shubham6531/ACC_-_Lane_Keep_Assist/Report_ACC_with_Lane_Keep.pdf

## AuE 8350

## Automotive Electronics Integration

## Project 2 Report

## Fall 2021

## Submitted By:

### Shubham Gupta

C38771108

### gupta9@clemson.edu

## Project 2: Adaptive Cruise Control and Autonomous Lane Keeping

### Task 1: Adaptive Cruise Control

### 1.1 Problem Statement

The vehicle shall be able to exhibit Adaptive Cruise Control capabilities, i.e, it should be able to autonomously change its speed such that it stays 30 cm away from the obstacles ahead. Furthermore, if the obstacle ahead is stationary, then the vehicle should stop 30 cm away from the obstacle.

### 1.2 Technical Approach

The vehicle was controlled using a Proportional-Integral-Derivative (PID) controller. The PID controller provided us with an easy yet robust method of implementing adaptive cruise control, and we did not need to model the system.

The PID controller can be represented using the following equation:

where:

- u(t): PID control variable
- e(t): Error signal
- Kp: Proportional Gain
- Ki: Integral Gain
- Kd: Derivative Gain

However, since Arduino can only handle discrete data, we implement the PID controller on an Arduino as follows:

u(k) = u(k-1) + k1*e(k) + k2*e(k-1) + k3*e(k-2);

where:
- k1 = kp + ki + kd
- k2 = ‐kp ‐2*kd
- k3 = kd

### 1.3 Hardware and Software Implementation:

The following pictures demonstrate our setup for the project:

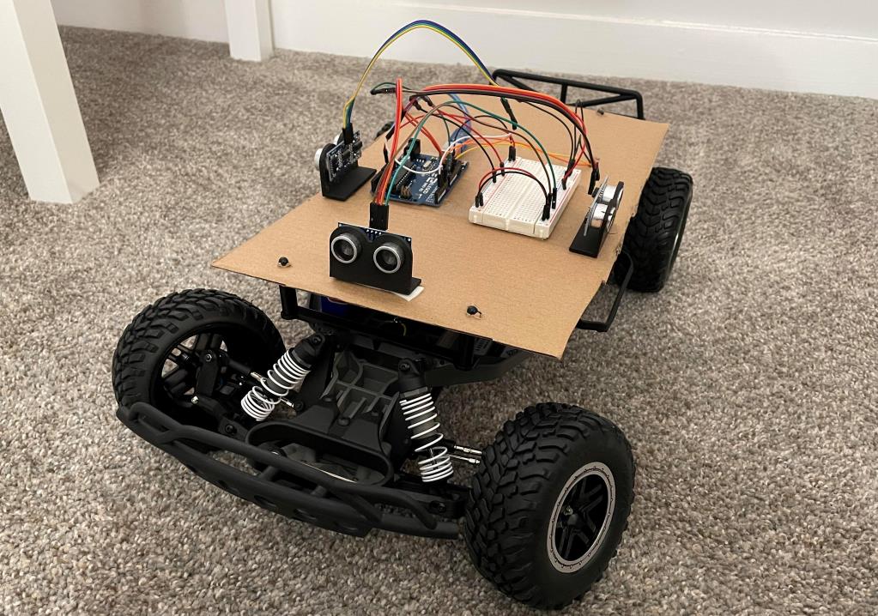
[picture p1: figure]

Our setup consisted of the following components
- RC Car
- Arduino Uno
- Front: One HC-SR04 sensor
- Sides: One HC-SR04 sensor each on left and right sides of the vehicle
- Breadboard
- Cardboard base to place the components
- Connecting wires

Additional Components (optional):

- 3D Printed Sensor Mounts

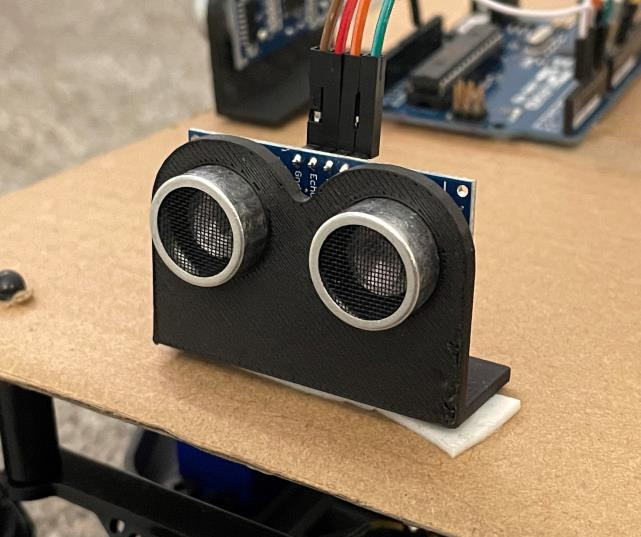
[picture p2: figure]

- Power Bank (to power Arduino)

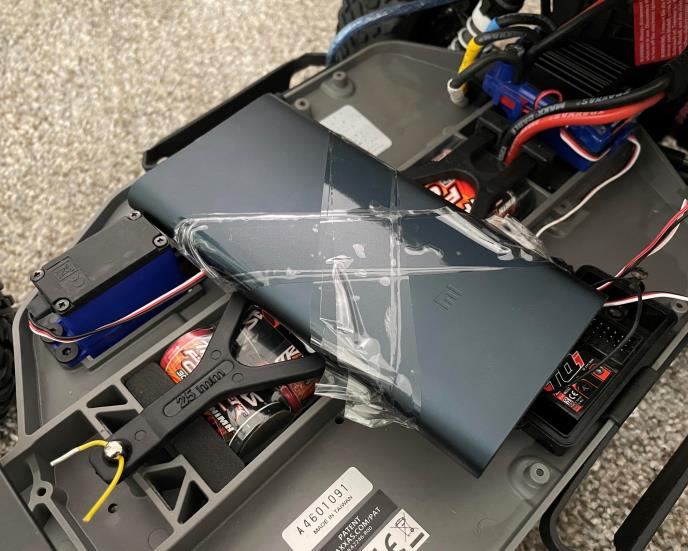
[picture p3: figure]

PID Controller Implementation
The PID Controller is a non-model based controller and is implemented using the discrete data version on an Arduino. For Adaptive Cruise Control, the PID uses data from the ultrasonic sensor in the front to calculate error signal, and provide the required throttle response.
- Throttle = 90 for zero throttle
- Throttle > 90 for forward acceleration
- Throttle < 90 for backward acceleration

The PID controller parameters are as follows:

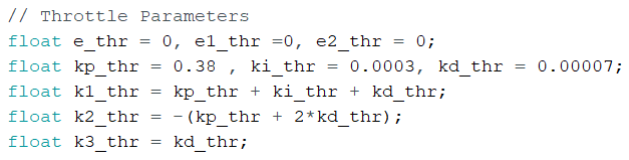
[picture p4: figure]

Handling the Dead Zone
The RC car motor has a noticeable dead zone (between throttle = 86 and throttle = 94). Therefore, we need to handle this by starting the forward throttle values at 94 and backward throttle values at
86. Therefore, the PID controller is implemented as follows on the Arduino:

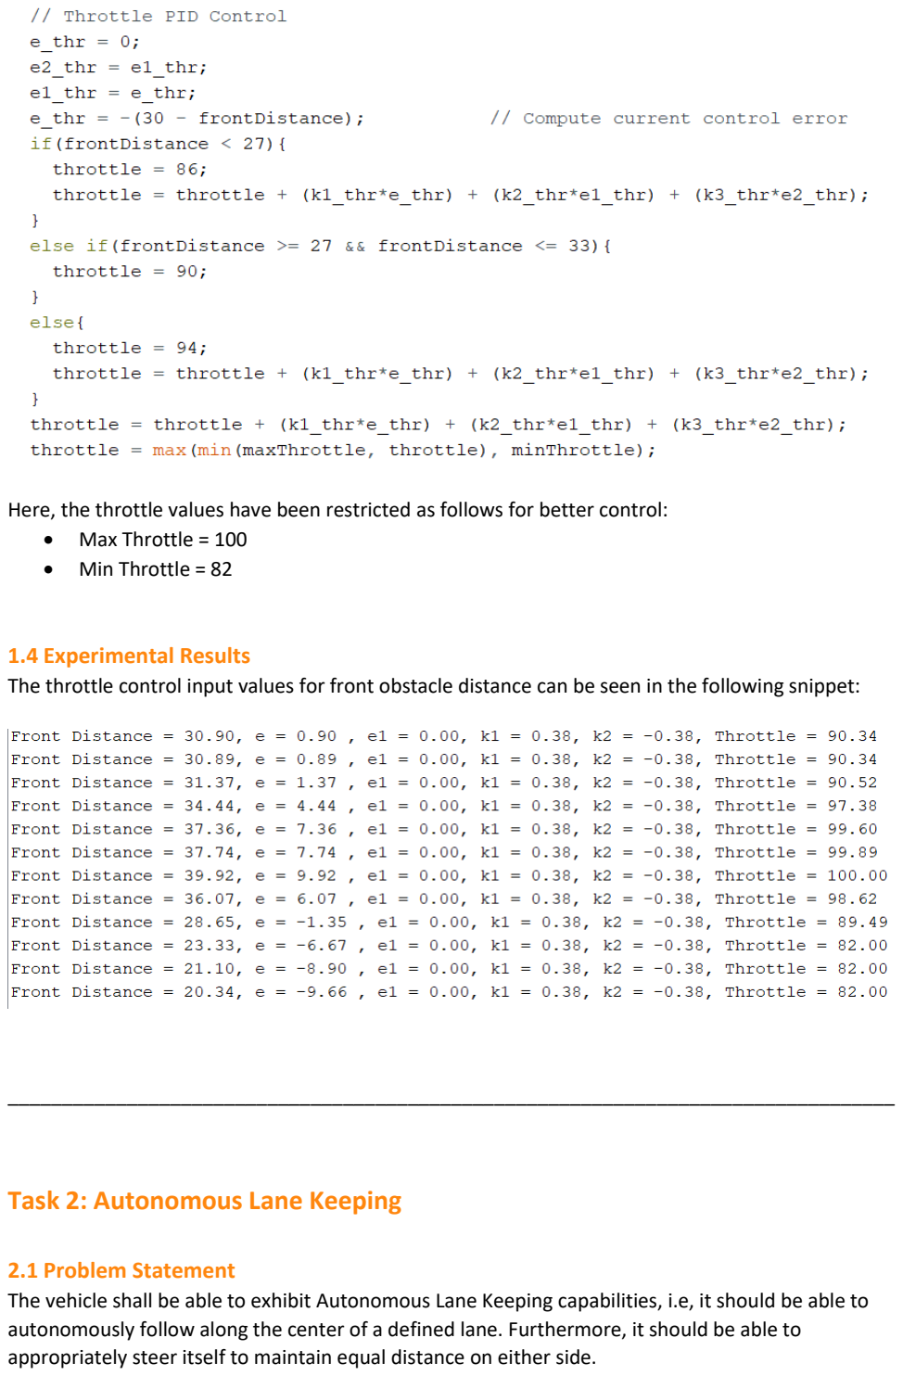
[picture p5: page 5]

Here, the throttle values have been restricted as follows for better control:
- Max Throttle = 100
- Min Throttle = 82

### 1.4 Experimental Results

The throttle control input values for front obstacle distance can be seen in the following snippet:

__________________________________________________________________________________

### Task 2: Autonomous Lane Keeping

### 2.1 Problem Statement

The vehicle shall be able to exhibit Autonomous Lane Keeping capabilities, i.e, it should be able to autonomously follow along the center of a defined lane. Furthermore, it should be able to appropriately steer itself to maintain equal distance on either side.

### 2.2 Technical Approach

The Autonomous Lane Keeping assist was controlled using a Proportional-Integral-Derivative (PID) controller. The PID controller provided us with an easy yet robust method and we did not need to model the system.

The PID controller can be represented using the following equation:

where:

- u(t): PID control variable
- e(t): Error signal
- Kp: Proportional Gain
- Ki: Integral Gain
- Kd: Derivative Gain

However, since Arduino can only handle discrete data, we implement the PID controller on an Arduino as follows:

u(k) = u(k-1) + k1*e(k) + k2*e(k-1) + k3*e(k-2);

where:
- k1 = kp + ki + kd
- k2 = ‐kp ‐2*kd
- k3 = kd

### 2.3 Hardware and Software Implementation:

The hardware implementation is the same as that in Task 1 (Adaptive Cruise Control). The following pictures demonstrate our setup for the project:

Our setup consisted of the following components
- RC Car
- Arduino Uno
- Front: One HC-SR04 sensor
- Sides: One HC-SR04 sensor each on left and right sides of the vehicle
- Breadboard
- Cardboard base to place the components
- Connecting wires
- 3D Printed Sensor Mounts
- Power Bank (to power Arduino)

PID Controller Implementation

The PID Controller is a non-model based controller and is implemented using the discrete data version on an Arduino. For Autonomous Lane Keeping, the PID uses data from the ultrasonic sensors on the left and right to calculate error signal, and provide the required steering response.
- Throttle = 90 for neutral steering i.e no turning
- Throttle > 90 for turning right
- Throttle < 90 for turning left

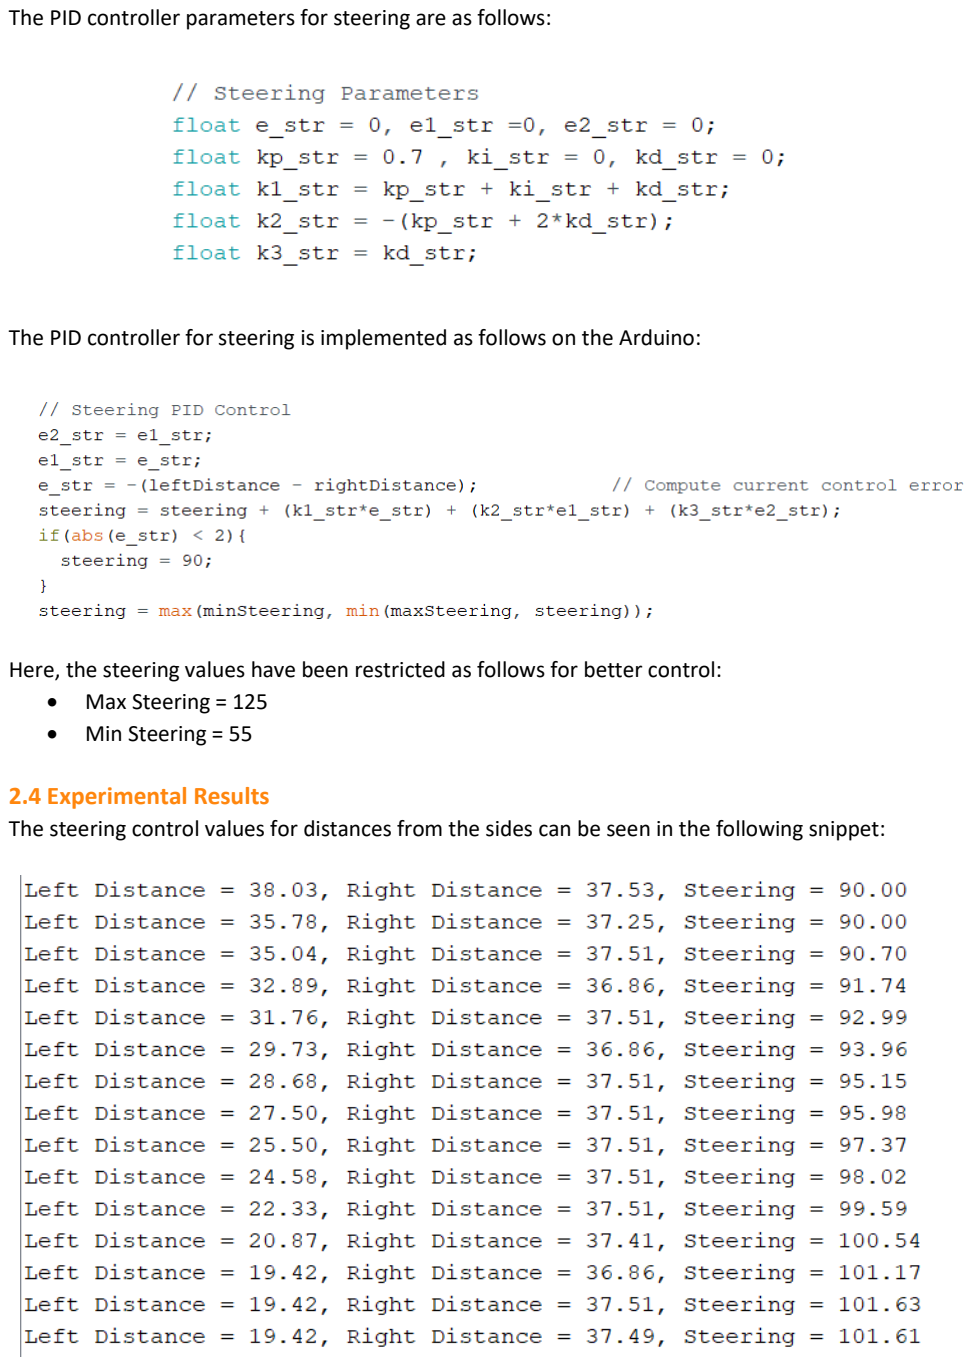
[picture p6: page 8]

The PID controller parameters for steering are as follows:

The PID controller for steering is implemented as follows on the Arduino:

Here, the steering values have been restricted as follows for better control:
- Max Steering = 125
- Min Steering = 55

### 2.4 Experimental Results

The steering control values for distances from the sides can be seen in the following snippet:

### Conclusions and Discussion

### 1.1 Conclusions

- Impact of Battery SOC:
- The state of charge of the RC vehicle battery impacted the throttle response of the vehicle. At a higher state of charge, the acceleration experienced for the same throttle input was higher.
- As a result, the response of the PID controller for the given Kp, Ki and Kd parameters changed significantly.
- Throttle Dead Zone:
- As discussed, the throttle input experiences a dead zone. Therefore, it is essential to identify the range of the dead zone and incorporate that information into the controller.
- Data Type for Variables:
- An interesting find was that the chosen data type for a variable can significantly impact results. For example, if the variable corresponding to throttle input is taken as an integer, the throttle values keep decreasing for a constant obstacle distance. Whereas, using a float variable avoids this issue.
- Sensor Noise:
- The ultrasonic sensors are prone to noise and can adversely impact throttle response if measured distance has very high inaccuracy.
- Power Source for Steering Servo
- Power the steering servo motor using the Arduino introduces noise in the ultrasonic sensor readings whenever the servo draws current from the Arduino. Therefore, it is recommended that the servo is powered from the ESC.

### 1.2 Discussion

Even though the PID controller has proved to be a good implementation technique, we can obtain more robust control using model-based controllers. Controllers such as Model Predictive Control (MPC) can provide better results.

Apart from the model-based controllers, other non-model-based controllers such as Reinforcement learning and Supervised learning techniques can also provide robust control. The only challenge with these approaches is that they require significant amount of training data to perform well.
