shubham6531/ACC_-_Lane_Keep_Assist/Report_Kalman_Filtering.pdf

## AuE 8350

## Automotive Electronics Integration

## Project 1 Report

## Fall 2021

## Submitted By:

### Shubham Gupta

C38771108

### gupta9@clemson.edu

## Project 1: Sensing Signal Processing

### Task 1: Signal Processing for One Ultrasonic Sensor

### 1.1 Problem Statement

The Task 1 aims to implement a Kalman filter using an Arduino microcontroller to filter the noise from an ultrasonic sensor reading. In general, an ultrasonic sensor is used to measure distance of an object in front of it. While the ultrasonic sensor can be used without a filter, the obtained measurements are noisy, and we obtain fluctuations in measurements for the same distance. Therefore, a simple yet powerful filter like the Kalman filter is implemented in this project.

To achieve the above goal, the following steps need to be fulfilled:
- Sampling: Sample the time data of an ultrasonic sensor as quickly as possible
- Filtering: Implement a Kalman filter to filter out the noise from the readings
- Calibration: Identify an appropriate function to map the measured time values to the corresponding distance values

Furthermore, the following performance metrics need to be met for the Kalman filter:
- Converge the Kalman filter as quickly as possible (less than 10 seconds)
- Accuracy of calculated distance must be within +/-3 mm

### 1.2 Technical Approach

The task at hand was fulfilled by completing the steps highlighted in the problem statement as follows:

### 1. Sampling

Time readings were sampled from the ultrasonic sensor as fast as possible.
- For our project, chosen sampling time = 10 milliseconds
- Note that these measured time values are noisy and need to be filtered to obtain a reliable time value. The following snippet shows time values for the same distance:

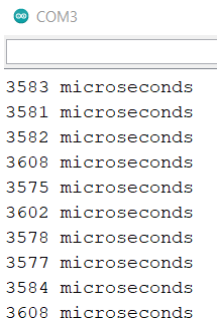
[picture p7: figure]

### 2. Kalman Filter

To implement a Kalman filter for one ultrasonic sensor, the following Prediction and Correction equations were used:

Process Model:
yk = 1*yk‐1
zk = 1*yk + vk

where:
- y: system state (time values)
- k: discrete time value
- z: measured data (time measurement from sensor)
- v: measurement noise
Prediction | Correction
‐ ŷ k = yk‐1 ‐ P k = Pk‐1 where: • ŷ ‐ k : Predicted value based on previous measurement • P ‐ k : Predicted error covariance | K = P‐ k (P‐ k + R)‐1 ŷk = ŷ‐ k + K(zk ‐ ŷ‐ k) Pk = (I ‐K) P ‐ k where: • K: Kalman Gain • ŷk : Estimated State • Pk : Estimated error covariance
i) Error Covariance R
To implement Kalman filter using above equations, we first need to determine the error covariance R. This was determined by taking 100 samples each at different distances from the sensor within the CU-ICAR auditorium and calculating the covariance within those measurements. The calculated error covariances were then included in our codes for Kalman filter.

The code for calculating R is as follows:

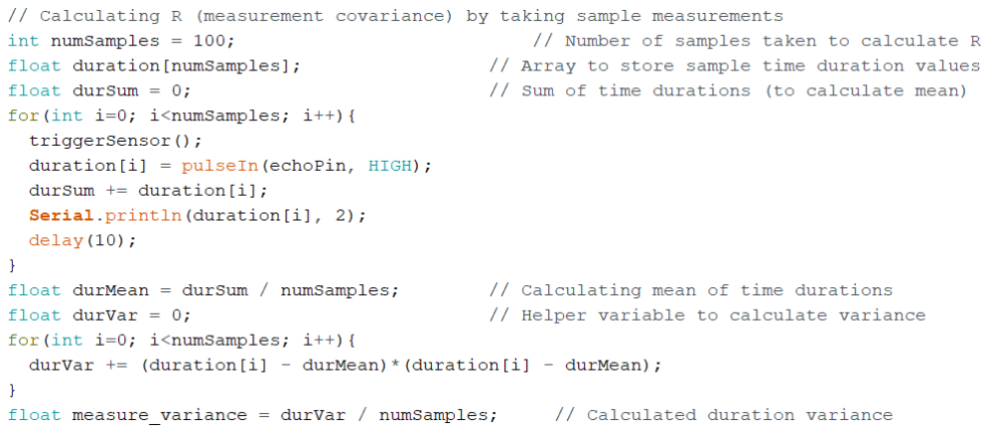
[picture p8: figure]
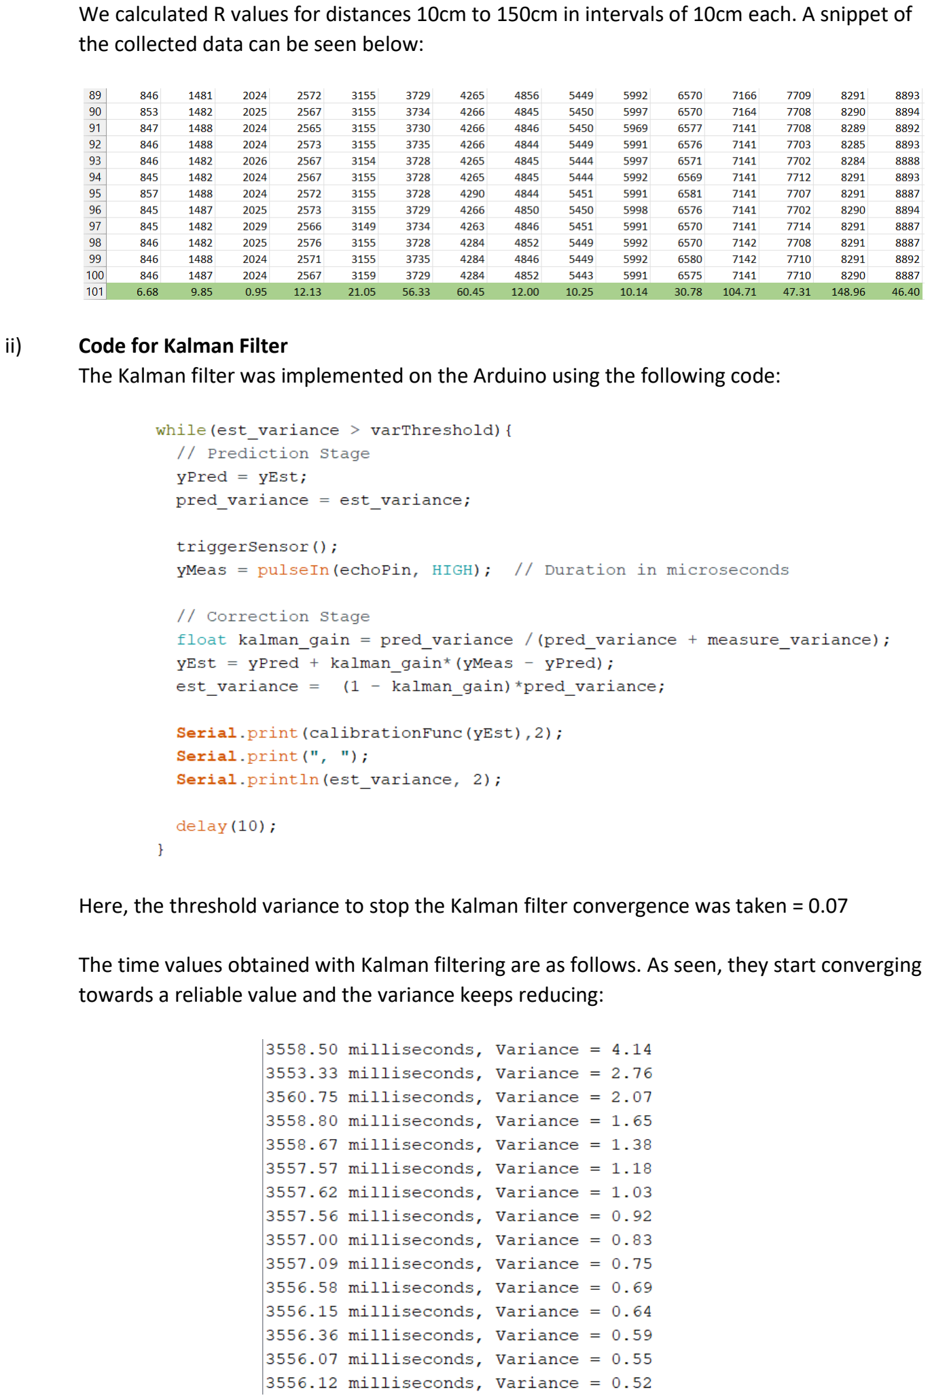
[picture p9: page 4]

We calculated R values for distances 10cm to 150cm in intervals of 10cm each. A snippet of the collected data can be seen below:

ii) Code for Kalman Filter The Kalman filter was implemented on the Arduino using the following code:

Here, the threshold variance to stop the Kalman filter convergence was taken = 0.07

The time values obtained with Kalman filtering are as follows. As seen, they start converging towards a reliable value and the variance keeps reducing:

### 3. Calibration:

The obtained filtered time values after Kalman filter need to be mapped to a physical distance value. To achieve this, we need to obtain a calibration function for the sensor being used. This function can be obtained as follows:

i) Obtain filtered time values for various distances:
The sensor was placed at various distances from an obstacle in front at the CU-ICAR auditorium to obtain the closest environment to the testing area. The corresponding filtered time values were noted. Similarly, the actual physical distance was measured using a measuring tape. These data were noted down as follows:

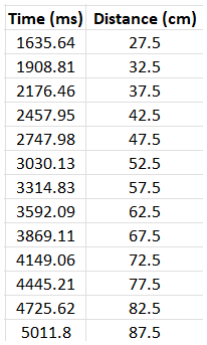
[picture p10: figure]

ii) Plot obtained data and Polyfit The obtained data was plotted in Matlab and polyfit function. Furthermore, since the graph appeared to have regions, we used a piece-wise function for calibration, which was obtained by using Polyfit function on the individual pieces of the graph:

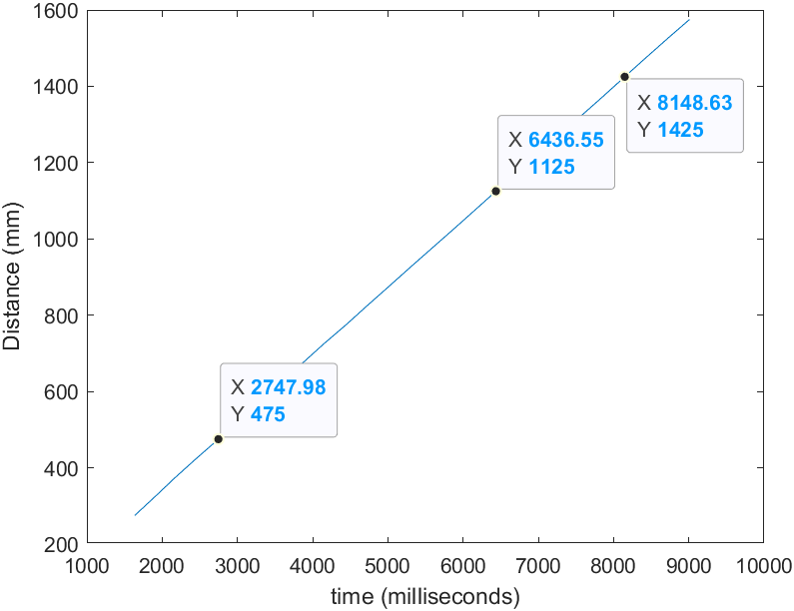
[picture p11: figure]

iii) Include Calibration Function in code The obtained piece-wise calibration function was added to the code to be able to obtain filtered distance values using the sensor.

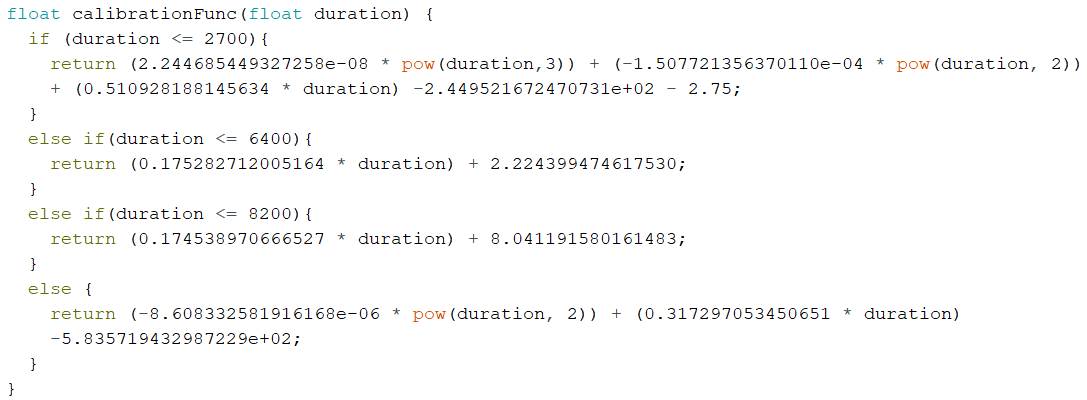
[picture p12: figure]

### 1.3 Hardware and Software Implementation:

The following circuit diagram demonstrates the setup used by our group for the project:

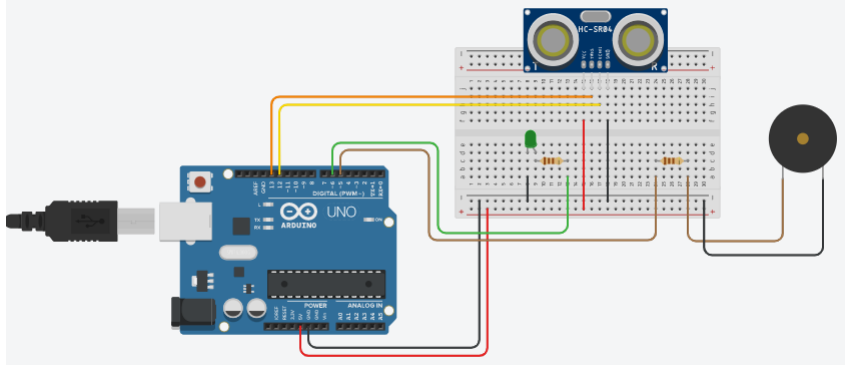
[picture p13: figure]

The components used are as follows:
- Arduino Uno R3
- One Ultrasonic Sensor (HC SR04)
- USB Cable
- 1 Breadboard
- 1 LED
- 1 Buzzer
- 2 Resistances (110 Ohms)
- Connecting wires

### 1.4 Experimental Results

The obtained distance values (in mm) and corresponding error covariance after the Kalman filter can be seen as follows:

Further Accomplishments:

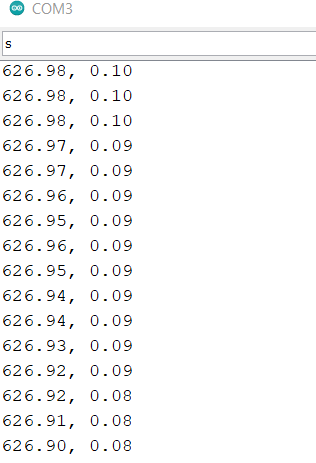
[picture p14: figure]

- The Kalman filter converges within 6 seconds for distance values from 20 cm to 150 cm
- The sensor setup is ideal for measuring distances within the above specified range at the CU-ICAR auditorium.
- Threshold variance for setup = 0.07

__________________________________________________________________________________

### Task 2: Sensor Fusion of Multiple Ultrasonic Sensors

### 2.1 Problem Statement

This task aims to fuse two ultrasonic sensors using the Kalman filter approach with the help of an Arduino microcontroller.

To achieve the above goal, the following steps need to be fulfilled:
- Sampling: Sample the time data of at least two ultrasonic sensors as quickly as possible
- Calibration: Identify appropriate calibration functions to map the measured time values to the corresponding distance values for each sensor
- Fusion: Implement a Kalman filter to fuse the readings from these multiple sensors and estimate the true distance.

Furthermore, the following performance metrics need to be met for the Kalman filter:
- Converge the Kalman filter as quickly as possible (less than 10 seconds)
- Accuracy of calculated distance must be within +/-3 mm

### 2.2 Technical Approach

The task at hand was fulfilled by completing the steps highlighted in the problem statement as follows:

### 1. Sampling

Time readings were sampled from the two ultrasonic sensors as fast as possible.
- For our project, a delay of 10 milliseconds was used between measurement readings from the two sensors. Furthermore, another delay of 10 milliseconds was used before taking the next set of measurements from the two sensors.

### 2. Calibration:

We derive the calibration function for the second sensor in this task (the sensor from Task 1 is being reused for sensor 1). The calibration function for sensor 2 is obtained using the same approach as in Task 1. The obtained piece-wise calibration function is as follows:

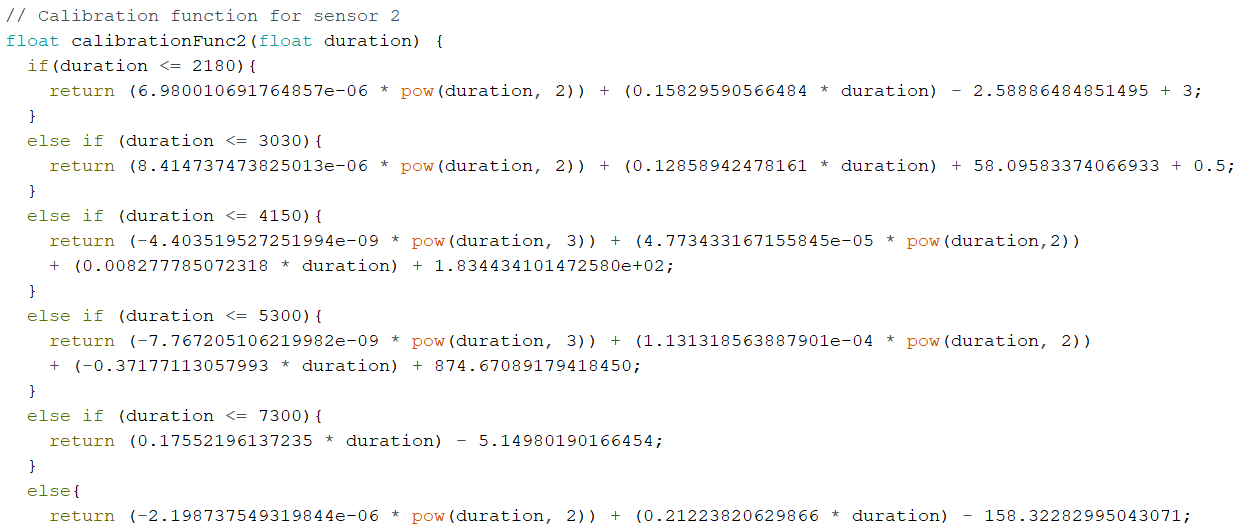
[picture p15: figure]

### 3. Kalman Filter

As opposed to Task 1, in Task 2 we implement the Kalman filter on distance values (obtained from raw time values). To implement a Kalman filter for two ultrasonic sensors, the following Prediction and Correction equations were used:

Process Model:
yk = 1*yk‐1
z1,k = 1*yk + v1,k
z2,k = 1*yk + v2,k

where:
- y: system state (time values)
- k: discrete time value
- z: measured data (time measurements from sensor 1 and 2)
- v: measurement noise

Prediction | Correction
ŷ ‐ k = yk‐1 ‐ P k = Pk‐1 where: • ŷ ‐ k : Predicted value based on previous measurement ‐ • P k : Predicted error covariance | Correction 1: K = P‐ k (P‐ ‐1 k + R1) ŷ1,k = ŷ‐ k + K(z1,k ‐ ŷ‐ k) P1,k = (I ‐K) P‐ k Correction 2: K = P1,k (P1,k + R2) ‐1 ŷk = ŷ1,k + K(z2,k ‐ ŷ1,k) Pk = (I ‐K) P1,k where: • K: Kalman Gain • ŷk : Estimated State • Pk : Estimated error covariance
i) Error Covariance R
To implement Kalman filter using above equations, we first need to determine the error covariance R. The difference for Task 2 is that the R values are determined using distance data instead of time data.

A snippet of the collected data can be seen below. The columns show distance values (in mm) for distances ranging from 10cm to 150cm in intervals of 10cm each. The last row indicates the R values for the distance interval.

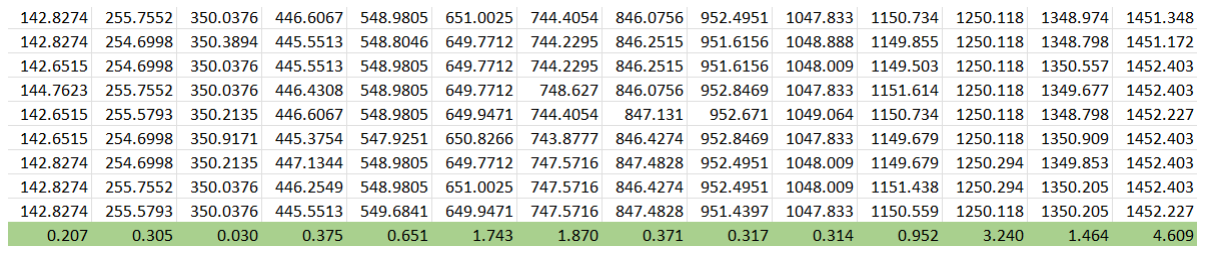
[picture p16: figure]

iii) Code for Kalman Filter The Kalman filter was implemented on the Arduino using the following code:

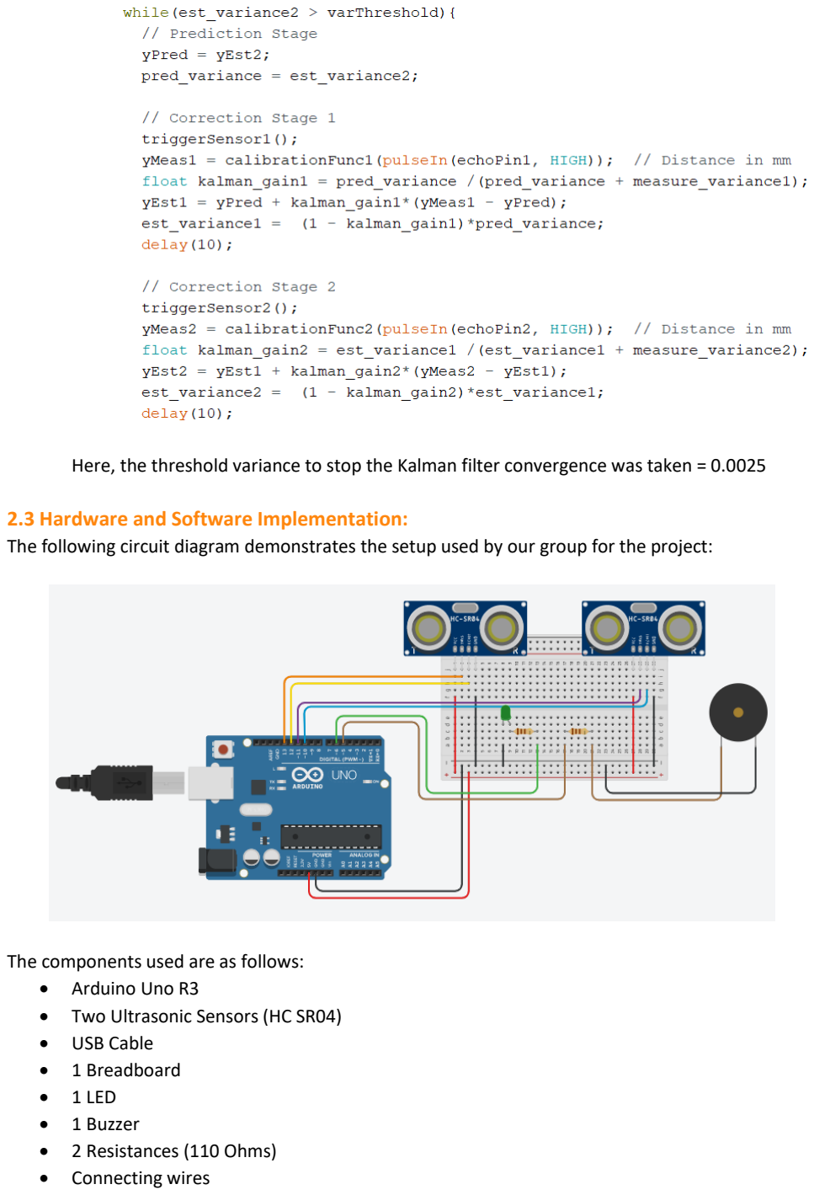
[picture p17: page 10]

Here, the threshold variance to stop the Kalman filter convergence was taken = 0.0025

### 2.3 Hardware and Software Implementation:

The following circuit diagram demonstrates the setup used by our group for the project:

The components used are as follows:
- Arduino Uno R3
- Two Ultrasonic Sensors (HC SR04)
- USB Cable
- 1 Breadboard
- 1 LED
- 1 Buzzer
- 2 Resistances (110 Ohms)
- Connecting wires

### 2.4 Experimental Results

The obtained distance values (in mm) after fusion and corresponding error covariance after the Kalman filter can be seen in the following snippet. Furthermore, the convergence time of the Kalman filter can also be seen in the last row:

Further Accomplishments:

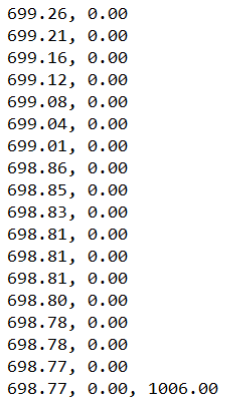
[picture p18: figure]

- The Kalman filter converges within a maximum of 8 seconds for distance values from 20 cm to 150 cm
- The sensor fusion setup is ideal for measuring distances within the above specified range at the CU-ICAR auditorium.
- Threshold variance for setup = 0.0025

### ________________________________________________________________

### Conclusions and Discussion

### 3.1 Conclusions

- Kalman filter is a simple yet powerful tool to remove noise from sensor readings. Furthermore, it can successfully fuse data from multiple sensors as well.
- Accurate calibration functions are essential for determining distance values with high precision. While a standard formula using the speed of sound could be used as well, the formula does not capture the variations of the testing environment.
- Fusing two ultrasonic sensors results in distance values with higher precision and reliability.

### 3.2 Discussion

- Convergence Time:
- The Kalman filter’s convergence time can be substantially reduced by selecting suitable initial values for error covariance

- To determine the suitable error covariance values, we can follow the approach in sections 1.2.2 and 2.2.3 and calculate the R values beforehand. This helps in further reduction of the overall convergence time.
- Sensor Selection:
- Different sensors have varying degrees of covariances. In order to obtain reliable results, we calculated covariance values for all sensors to determine the most reliable sensors
- Calibration Environment:
- The data collected to obtain the calibration function, captures the nuances of the surrounding environment. Hence, it is crucial that the calibration environment is kept same as the environment in which the setup will be used.
